DaQi0510/DDS_Ven2/程序版本说明.txt

STM32F407_C      液晶显示中文
STM32F407_E_P    液晶显示英文，S19引脚输出与三角波1配合输出PWM
STM32F407_E_T    液晶显示英文，S19引脚输出高低电平，通过开关进行控制
