DaQi0510/DDS_Ven2/2017年4月20日电路板修改.docx

# 2017年4月20日电路板修改要求

1、 外接显示器大小改为5寸，电路板到显示器接线长度不低于7m；
2、 三角波扫描频率改为10-500Hz，旋钮调节精度改为1Hz；
3、 旋钮接线改进，目前为直角接线，改为平行出线，接头强度需要提高。
