DaQi0510/DDS_Ven2/电路板2017年5月22日.pdf

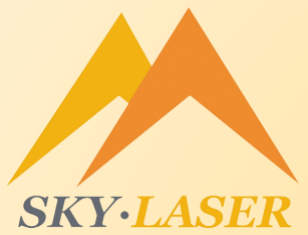
[picture p1: figure]

Laser Power | (模数转换百分比)%
Pulse | (方波频率，不显示KHz)
Red | on/off | (红光信号开关)
Laser | on/off | (开关信号)
Mode | 1/2 | (外部接口断开为1，闭合为2)
Width | （三角波1的幅值）

武汉翔明激光科技有限公司
WUHAN SKY LASER TECHNOLOGY CO. LTD.
