DaQi0510/DDS_Ven2/翔明开票资料.docx

开票资料

公司名称：武汉翔明激光科技有限公司

纳税人识别号：91420100MA4KLYFR6X
开户行：中国农业银行武汉华工支行
开户帐号：17039701040002998
注册地址：武汉市东湖新技术开发区高新大道999号海外人才大楼A座5楼505室
联系电话：027—87543894
