DaQi0510/DDS_Ven2/Hardware/Sch/料单.xlsx

Comment | Footprint | Quantity | Value
MAX903 | SOIC 8P | 2
OPA2350 | SOIC 8P | 2
STM32F407ZGT6 | STM32F407ZGT6-LQFP144 | 5
74LVC4245 | 74LVC4245-PW | 4
AT24C02D-SSHM-T | SOIC8 | 2
MP1584 | MP1584EN-SOIC-8P | 2
LT1963A | 贴片 | 2
LT1963-3.3 | 贴片 | 2
10uF10V钽电容 | CAP-3216 | 4
10uH | 0805 | 20
1k电阻 | 0603 | 100
3k电阻 | 0603 | 100
3.1k电阻 | 0603 | 100
