DaQi0510/DDS_Ven2/华中科技大学开票.xlsx

发票抬头：华中科技大学 （总计2409元）
名称 | 数量 | 单价 | 金额（元）
STM32F429ZGT6 | 15 | 60 | 900
LT1763-3.3 | 15 | 19 | 285
AD8622 | 15 | 28 | 420
LT1964ES5-5 | 15 | 17 | 255
74LVC4245 | 30 | 10 | 300
LT1963A | 15 | 16.6 | 249
