DaQi0510/DDS_Ven2/Hardware/Sch/dds.pdf

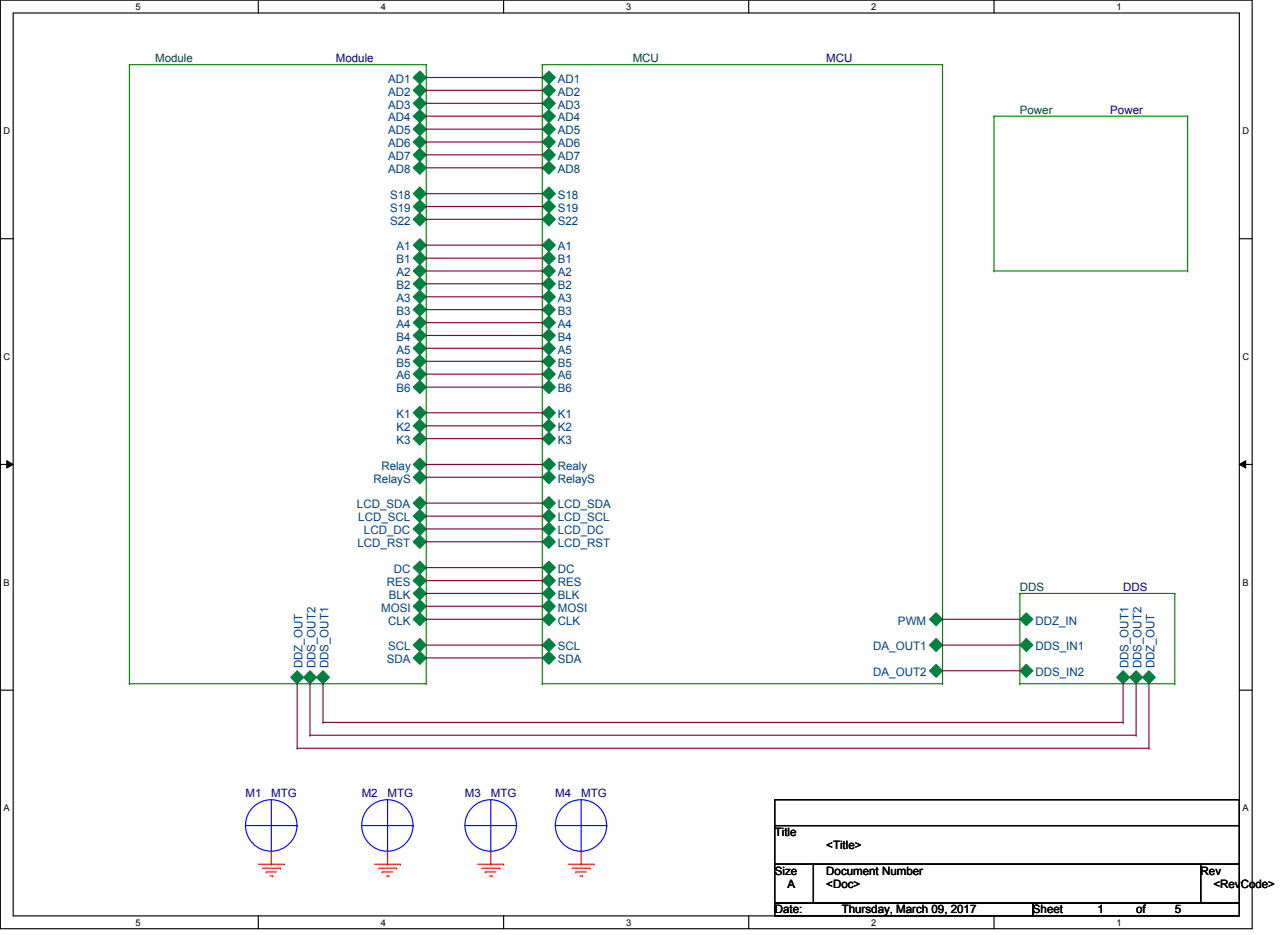
[picture p9: page 1]
Title; Size; Document Number; Rev; Date:; Sheet; <Doc>; <RevCode>; <Title>; Thursday, March 09, 2017; M1 MTG; DDS; DDZ_IN; DDS_OUT1 DDZ_OUT DDS_IN1; DDS_OUT2; DDS_IN2; M2 MTG; M3 MTG; Power; Module; Relay; SCL SDA; LCD_SCL; LCD_SDA; LCD_RST; LCD_DC; DDZ_OUT; RelayS; DDS_OUT1; CLK; MOSI; RES; BLK; M4 MTG; MCU; DA_OUT1; DA_OUT2; SDA; SCL; PWM; Realy

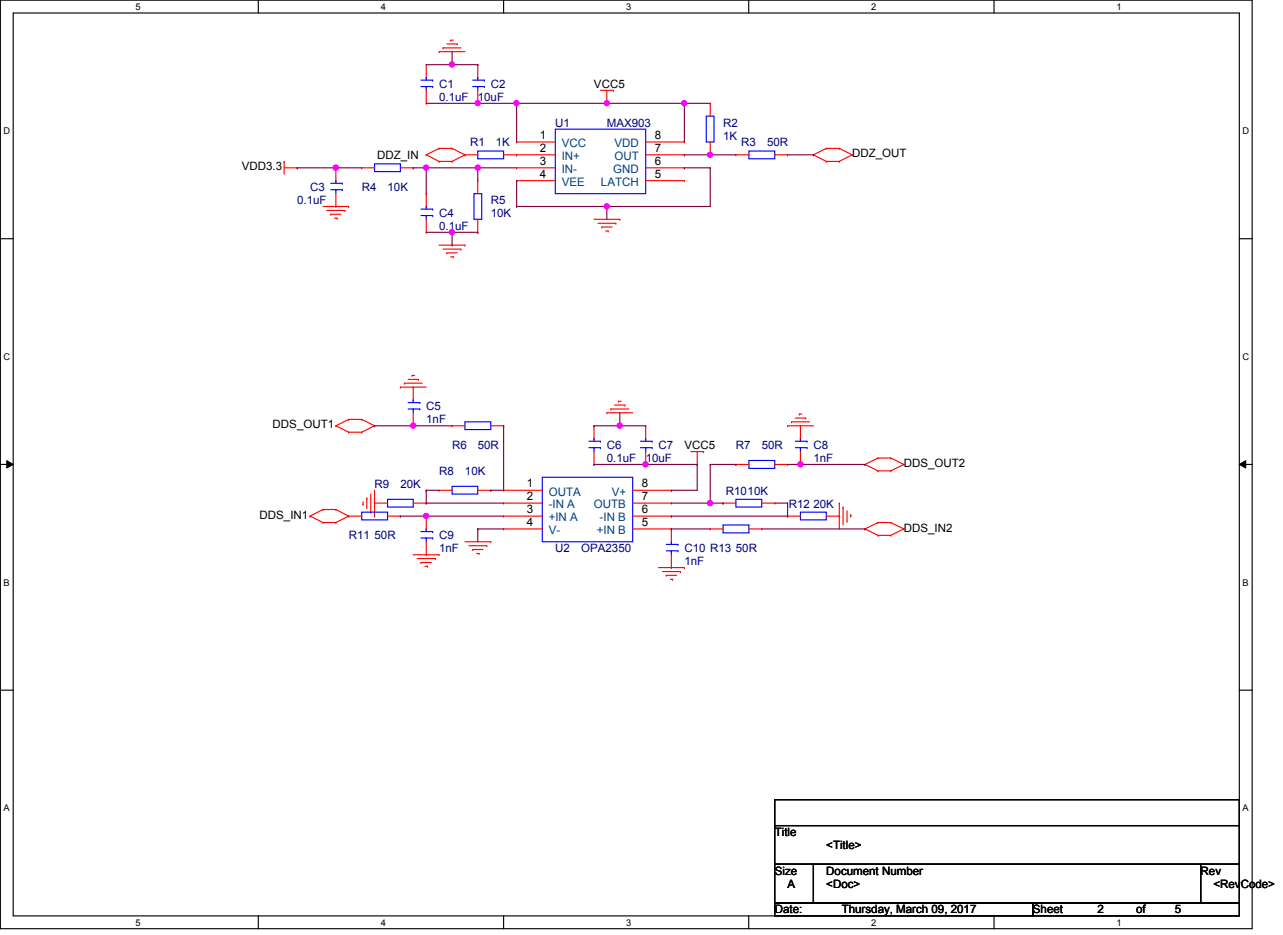
[picture p10: page 2]

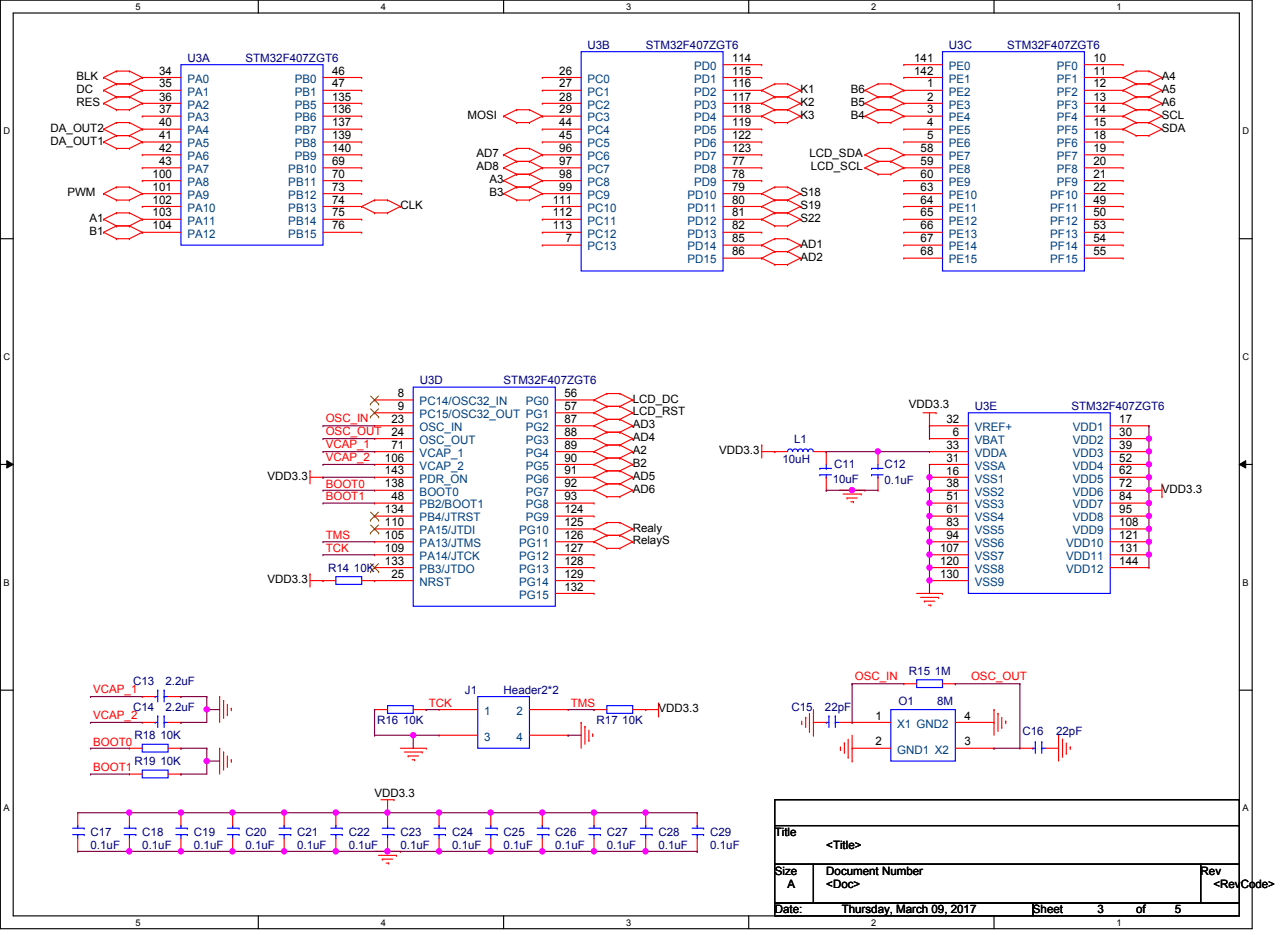
[picture p11: page 3]

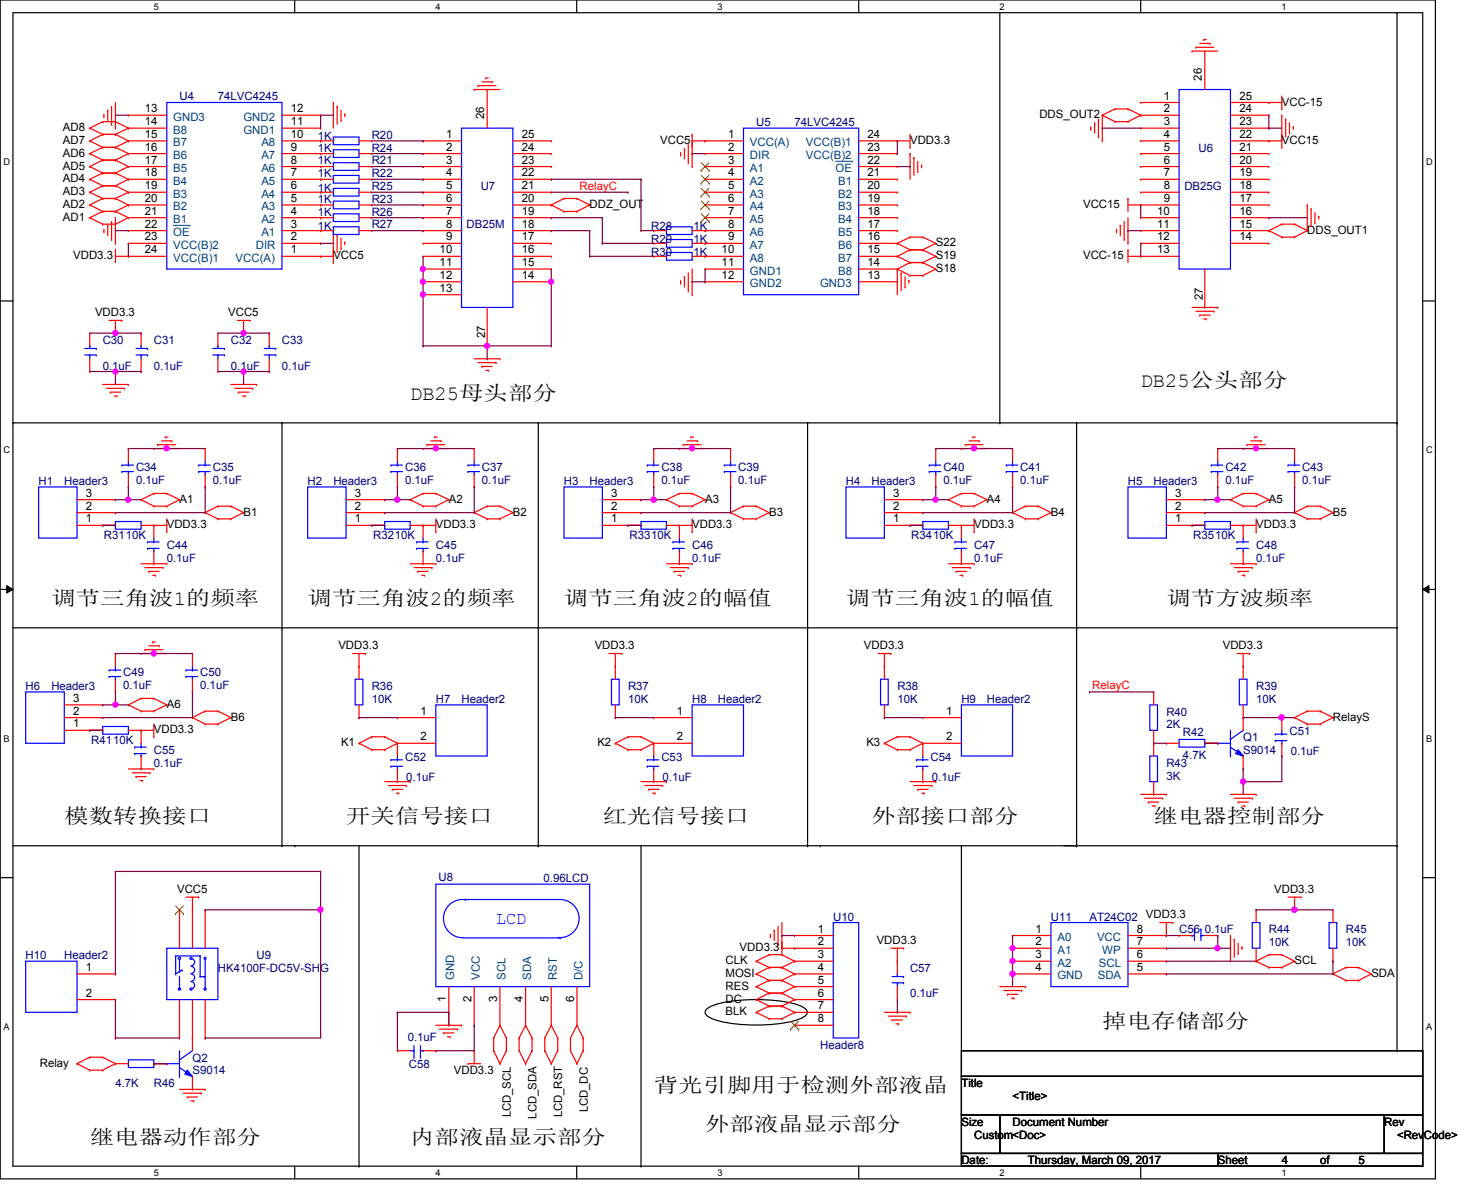
[picture p12: page 4]

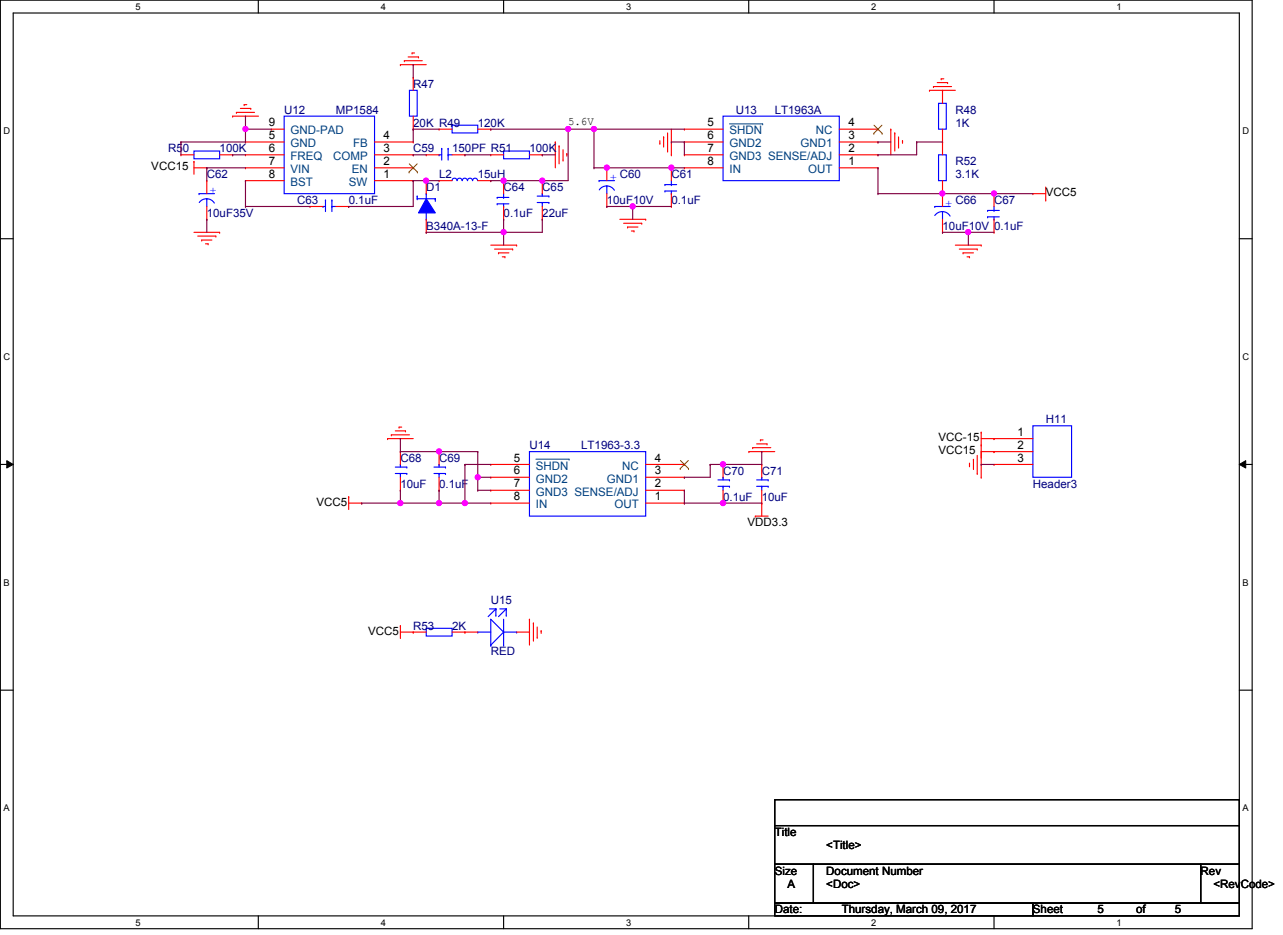
[picture p13: page 5]
