DaQi0510/DDS_Ven2/Hardware/Pcb/TOP.pdf

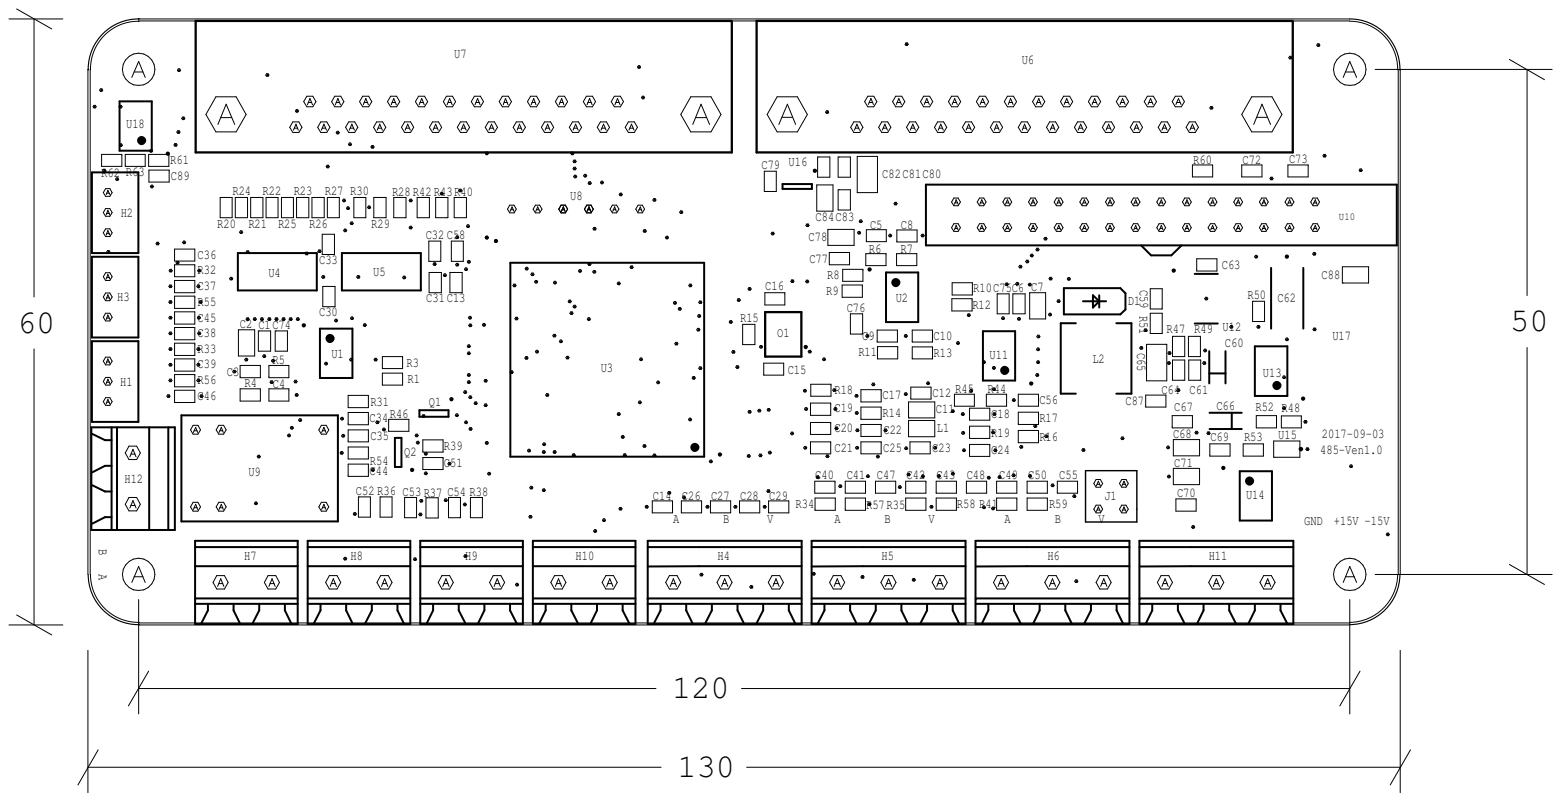
[picture p14: page 1]
