DaQi0510/DDS_Ven2/Hardware/Sch/尺寸图.pdf

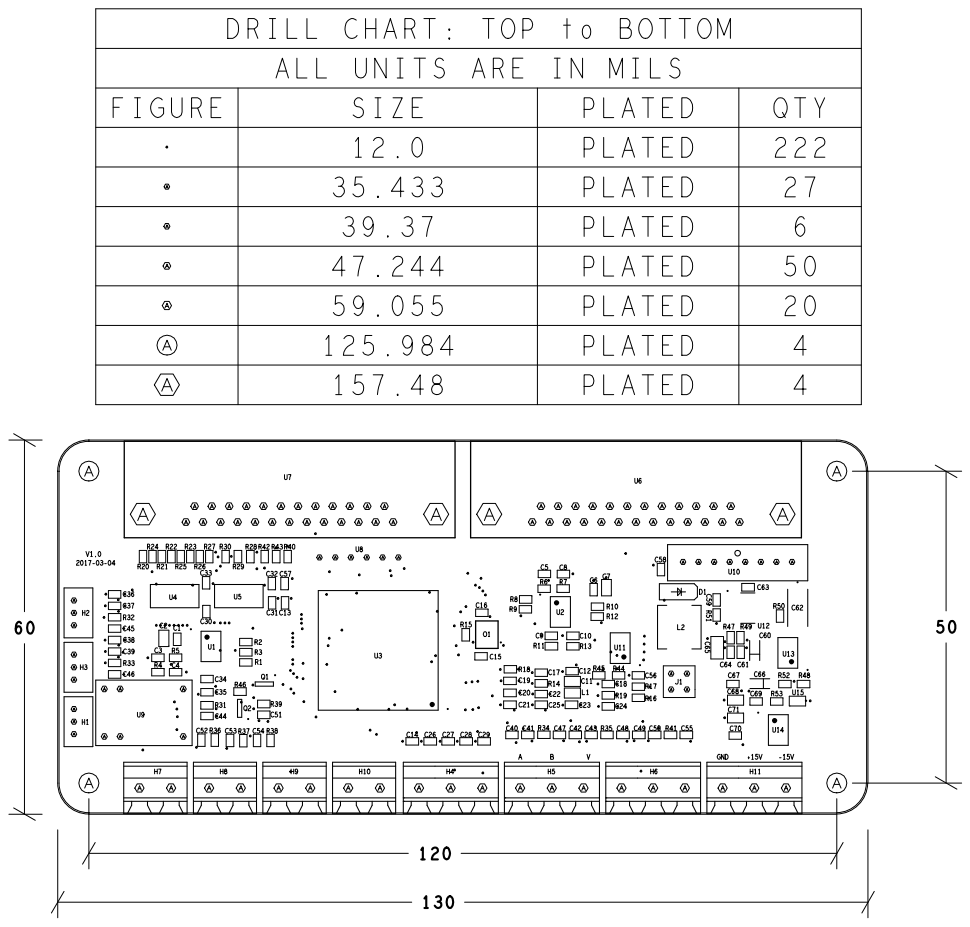
[picture p15: page 1]
