DaQi0510/DDS_Ven2/Hardware/Sch/尺寸图新.pdf

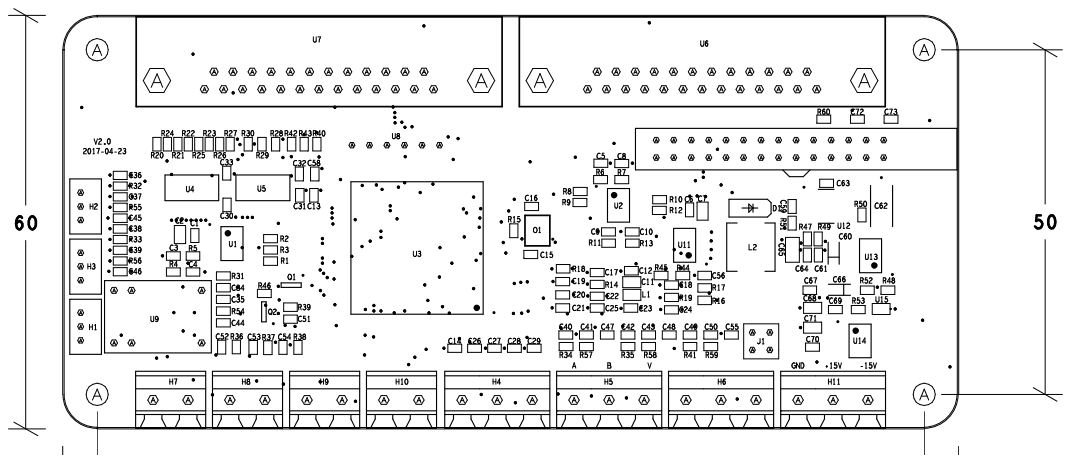
[picture p16: page 1]
