DaQi0510/DDS_Ven2/(list of files, drawings)

Other design files:
Hardware/Sch/DDS.DSN
Hardware/Sch/DDS.opj
