DaQi0510/DDS_Ven2/STM32F407_C/HARDWARE/X9C503/X9C503.c

#include "X9C503.h"
#include "stm32f4xx_dma.h"
#include "stm32f4xx_tim.h"

const uint8_t Escalator8bit[6] = {0x0, 0x33, 0x66, 0x99, 0xCC, 0xFF};
const uint16_t Sine12bit[32] = {
                      10, 20, 30, 40, 50, 60, 70, 80, 90, 100,
                      120, 150, 200, 300, 400, 500, 600, 1000, 1200, 1000, 
                      800, 700, 600, 500, 400, 38, 155, 344, 599, 909, 1263, 1647};
#define DAC_DHR8R1_ADDRESS     0x40007408
#define DAC_DHR12R2_ADDRESS    0x40007414
/*
	PF1->CS
	PF2->INC
	PF3->UD
*/
void X9C503_Init(void)
{
	GPIO_InitTypeDef  GPIO_InitStructure;
	
	RCC_AHB1PeriphClockCmd(RCC_AHB1Periph_GPIOF, ENABLE);
	GPIO_InitStructure.GPIO_Pin = GPIO_Pin_1 | GPIO_Pin_2 | GPIO_Pin_3;
  GPIO_InitStructure.GPIO_Mode = GPIO_Mode_OUT;//普通输出模式
  GPIO_InitStructure.GPIO_OType = GPIO_OType_PP;//推挽输出
  GPIO_InitStructure.GPIO_Speed = GPIO_Speed_100MHz;//100MHz
  GPIO_InitStructure.GPIO_PuPd = GPIO_PuPd_UP;//上拉
  GPIO_Init(GPIOF, &GPIO_InitStructure);//初始化GPIO	
	
	X9C503_CS=1;
	X9C503_INC=1;
	X9C503_UD=1;
}

void X9C503_SetValue(u8 Value)   //设置X9C503的值
{
	X9C503_CS=0;
	Delaysss();
//	if(X9C503Value<Value)
//	{
//		X9C503_UD=0;
//		Delaysss();
//		while(X9C503Value<Value)
//		{
//			X9C503_INC=0;
//			Delaysss();
//			X9C503_INC=1;
//			Delaysss();
//			X9C503Value++;
//		}
//	}
//	else
//	{
//		X9C503_UD=1;
//		Delaysss();
////		while(X9C503Value<Value)
////		{
////			X9C503_INC=0;
////			Delaysss();
////			X9C503_INC=1;
////			Delaysss();
////			X9C503Value++;
////		}
//	}
	X9C503_CS=1;
}

void Voltage_Init(void)
{
	GPIO_InitTypeDef  GPIO_InitStructure;
	DAC_InitTypeDef DAC_InitType;
	
  RCC_AHB1PeriphClockCmd(RCC_AHB1Periph_GPIOA, ENABLE);//使能GPIOA时钟
  RCC_APB1PeriphClockCmd(RCC_APB1Periph_DAC, ENABLE);//使能DAC时钟
	   
  GPIO_InitStructure.GPIO_Pin = GPIO_Pin_4;
  GPIO_InitStructure.GPIO_Mode = GPIO_Mode_AN;//模拟输入
  GPIO_InitStructure.GPIO_PuPd = GPIO_PuPd_DOWN;//下拉
  GPIO_Init(GPIOA, &GPIO_InitStructure);//初始化

	DAC_InitType.DAC_Trigger=DAC_Trigger_None;	//不使用触发功能 TEN1=0
	DAC_InitType.DAC_WaveGeneration=DAC_WaveGeneration_None;//不使用波形发生
	DAC_InitType.DAC_LFSRUnmask_TriangleAmplitude=DAC_LFSRUnmask_Bit0;//屏蔽、幅值设置
	DAC_InitType.DAC_OutputBuffer=DAC_OutputBuffer_Disable ;	//DAC1输出缓存关闭 BOFF1=1
  DAC_Init(DAC_Channel_1,&DAC_InitType);	 //初始化DAC通道1

	DAC_Cmd(DAC_Channel_1, ENABLE);  //使能DAC通道1
  
  DAC_SetChannel1Data(DAC_Align_12b_R, 0);  //12位右对齐数据格式设置DAC值
}
void DAC_Sine_Init(void)
{
	/* Preconfiguration before using DAC----------------------------------------*/
  GPIO_InitTypeDef GPIO_InitStructure;

  /* DMA1 clock and GPIOA clock enable (to be used with DAC) */
  RCC_AHB1PeriphClockCmd(RCC_AHB1Periph_DMA1 | RCC_AHB1Periph_GPIOA, ENABLE);
 
  /* DAC Periph clock enable */
  RCC_APB1PeriphClockCmd(RCC_APB1Periph_DAC, ENABLE);
   /* DAC channel 1 (DAC_OUT1 = PA.4) configuration */
  GPIO_InitStructure.GPIO_Pin = GPIO_Pin_4 ;
  GPIO_InitStructure.GPIO_Mode = GPIO_Mode_AN;
  GPIO_InitStructure.GPIO_PuPd = GPIO_PuPd_NOPULL;
  GPIO_Init(GPIOA, &GPIO_InitStructure);
	/* TIM6 Configuration ------------------------------------------------------*/
  TIM6_Config();
	DAC_Ch1_EscalatorConfig();
}
void TIM6_Config(void)
{
	TIM_TimeBaseInitTypeDef    TIM_TimeBaseStructure;
  /* TIM6 Periph clock enable */
  RCC_APB1PeriphClockCmd(RCC_APB1Periph_TIM6, ENABLE);
	
	 /* Time base configuration */
  TIM_TimeBaseStructInit(&TIM_TimeBaseStructure); 
  TIM_TimeBaseStructure.TIM_Period = 0xFF;          
  TIM_TimeBaseStructure.TIM_Prescaler = 0;       
  TIM_TimeBaseStructure.TIM_ClockDivision = 0;    
  TIM_TimeBaseStructure.TIM_CounterMode = TIM_CounterMode_Up;  
  TIM_TimeBaseInit(TIM6, &TIM_TimeBaseStructure);
	
	 /* TIM6 TRGO selection */
  TIM_SelectOutputTrigger(TIM6, TIM_TRGOSource_Update);
  
  /* TIM6 enable counter */
  TIM_Cmd(TIM6, ENABLE);
}
/**
  * @brief  DAC Channel1 Escalator Configuration
  * @param  None
  * @retval None
  */
void DAC_Ch1_EscalatorConfig(void)
{
  DMA_InitTypeDef DMA_InitStructure;
  DAC_InitTypeDef  DAC_InitStructure;
  /* DAC channel1 Configuration */
  DAC_InitStructure.DAC_Trigger = DAC_Trigger_T6_TRGO;
  DAC_InitStructure.DAC_WaveGeneration = DAC_WaveGeneration_None;
  DAC_InitStructure.DAC_OutputBuffer = DAC_OutputBuffer_Enable;
  DAC_Init(DAC_Channel_1, &DAC_InitStructure);

  /* DMA1_Stream5 channel7 configuration **************************************/  
  DMA_DeInit(DMA1_Stream5);
  DMA_InitStructure.DMA_Channel = DMA_Channel_7;  
  DMA_InitStructure.DMA_PeripheralBaseAddr = (uint32_t)DAC_DHR8R1_ADDRESS;
  DMA_InitStructure.DMA_Memory0BaseAddr = (uint32_t)&Sine12bit;
	DMA_InitStructure.DMA_DIR = DMA_DIR_MemoryToPeripheral;
  DMA_InitStructure.DMA_BufferSize = 32;
//  DMA_InitStructure.DMA_PeripheralDataSize = DMA_PeripheralDataSize_Byte;
//  DMA_InitStructure.DMA_MemoryDataSize = DMA_MemoryDataSize_Byte;
//  DMA_InitStructure.DMA_DIR = DMA_DIR_MemoryToPeripheral;
  DMA_InitStructure.DMA_PeripheralInc = DMA_PeripheralInc_Disable;
  DMA_InitStructure.DMA_MemoryInc = DMA_MemoryInc_Enable;
  DMA_InitStructure.DMA_Mode = DMA_Mode_Circular;
  DMA_InitStructure.DMA_Priority = DMA_Priority_High;
  DMA_InitStructure.DMA_FIFOMode = DMA_FIFOMode_Disable;         
  DMA_InitStructure.DMA_FIFOThreshold = DMA_FIFOThreshold_HalfFull;
  DMA_InitStructure.DMA_MemoryBurst = DMA_MemoryBurst_Single;
  DMA_InitStructure.DMA_PeripheralBurst = DMA_PeripheralBurst_Single;
  DMA_Init(DMA1_Stream5, &DMA_InitStructure);    
	/*
DMA_DeInit(DMA1_Stream5);
	DMA_InitStructure.DMA_Channel = DMA_Channel_7;  
	DMA_InitStructure.DMA_PeripheralBaseAddr = DAC_DHR12R1_ADDRESS;
	DMA_InitStructure.DMA_Memory0BaseAddr = (uint32_t)&sinTable;
	DMA_InitStructure.DMA_BufferSize = tableSize;
	DMA_InitStructure.DMA_PeripheralDataSize = DMA_PeripheralDataSize_HalfWord;
	DMA_InitStructure.DMA_MemoryDataSize = DMA_PeripheralDataSize_HalfWord;
	DMA_InitStructure.DMA_DIR = DMA_DIR_MemoryToPeripheral;
	DMA_InitStructure.DMA_PeripheralInc = DMA_PeripheralInc_Disable;
	DMA_InitStructure.DMA_MemoryInc = DMA_MemoryInc_Enable;
	DMA_InitStructure.DMA_Mode = DMA_Mode_Circular;
	DMA_InitStructure.DMA_Priority = DMA_Priority_High;
	DMA_InitStructure.DMA_FIFOMode = DMA_FIFOMode_Disable;         
	DMA_InitStructure.DMA_FIFOThreshold = DMA_FIFOThreshold_HalfFull;
	DMA_InitStructure.DMA_MemoryBurst = DMA_MemoryBurst_Single;
	DMA_InitStructure.DMA_PeripheralBurst = DMA_PeripheralBurst_Single;
	DMA_Init(DMA1_Stream5, &DMA_InitStructure);  
  */	
  DMA_Cmd(DMA1_Stream5, ENABLE);

  /* Enable DAC Channel1 */
  DAC_Cmd(DAC_Channel_1, ENABLE);

  /* Enable DMA for DAC Channel1 */
  DAC_DMACmd(DAC_Channel_1, ENABLE);
}
void SetVoltage(void)
{
//  double temp=VoltageValue;
//	temp/=1000;
//	temp=temp*4096/3.3;
//	DAC_SetChannel1Data(DAC_Align_12b_R,temp);//12位右对齐数据格式设置DAC值
}
void Delaysss(void)
{
	u8 i,j;
	for(i=0;i<2;i++)
		for(j=0;j<20;j++);
}
