DaQi0510/DDS_Ven2/STM32F407_C/HARDWARE/LCD/LCD.h

#ifndef __LCD_H
#define __LCD_H

#include "stm32f4xx_gpio.h"
#include "delay.h"

#define SET_LCD_DC GPIO_SetBits(GPIOG,GPIO_Pin_0)     //  PF0  片选
#define CLR_LCD_DC GPIO_ResetBits(GPIOG,GPIO_Pin_0)

#define SET_LCD_RST GPIO_SetBits(GPIOG,GPIO_Pin_1)    //  PF1  复位
#define CLR_LCD_RST GPIO_ResetBits(GPIOG,GPIO_Pin_1)

#define SET_LCD_SDA GPIO_SetBits(GPIOB,GPIO_Pin_11)     //  PF2  数据位
#define CLR_LCD_SDA GPIO_ResetBits(GPIOB,GPIO_Pin_11)

#define SET_LCD_SCL GPIO_SetBits(GPIOB,GPIO_Pin_10)     //  PF3  数据位
#define CLR_LCD_SCL GPIO_ResetBits(GPIOB,GPIO_Pin_10)

 void LCD_Init(void);
 void LCD_P6x8Str(u8 x,u8 y,u8 ch[]);
 void LCD_ShowNum(u8 x,u8 y, unsigned int num);
 void LCD_Show_M(u8 y,unsigned long int num);
 void LCD_Display(void);
 void LCD_ShowADNum(u8 Value);
 void LCD_ShowPulse(u16 Value);
 void LCD_ShowSine1(u16 Amp,u16 Fre);
 void LCD_ShowSine2(u16 Amp,u16 Fre);
 void LCD_ShowRed(u8 Value);
 void LCD_ShowLaser(u8 Value);
 void LCD_ShowMode(u8 Value);
void LCD_ShowWarning(u8 Value);
 
#endif
