DaQi0510/DDS_Ven2/(commit log)

2017-04-24 第二版，TFT4.3寸屏，PCB完成
    [BOM.xlsx, DDS.DSN, DDS.brd, DDS.opj, art_param.txt, cases.cfg, nc_param.txt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]
2017-05-07 添加负电源
    [DDS.DSN, DDS.brd, DDS.opj, unnamed.brd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]
2017-05-20 添加负电源，PCB完成
    [DDS.DSN, DDS.brd, DDS.opj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]
2017-07-03 添加各个版本程序
    [BOM.xlsx, DDS.DSN, DDS.brd, DDS.opj, unnamed.brd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]
2018-01-24 要求更改LASER按键信号控制方波输出版本前
    [DDS.brd, DDS.opj, 华中科技大学开票.xlsx, 金额明细.xlsx]
2018-01-24 STM32F407_E_T版本更改为K1开关控制PWM方波输出
2018-02-25 2018-02-24 RS485_Ven1.0 更改LT1963-3.3电源
    [DDS.DSN, DDS.brd, DDS.opj, art_param.txt, nc_param.txt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]
