DaQi0510/DDS_Ven2/(notices)

Notices in the files:
STM32F407_E_T/HARDWARE/PWM/bsp.h:
Copyright (C), 2013-2014, °²¸»À³µç×Ó www.armfly.com
STM32F407_E_T/HARDWARE/PWM/bsp_tim_pwm.c:
Copyright (C), 2015-2016, °²¸»À³µç×Ó www.armfly.com
